lu7did/QCX-SSB/USDX_V2/README.md

USDX_V2
======

Spanish version of the QCX-SSB code ported by Pablo Cardeñosa (EA2EHC) for his board
the USDX_V2.
The board implements the firmware on a standard Arduino Nano board running
at 16 MHz.

The original of this file should be retrieved from the files section of the
groups.io/ucx forum.
