lu7did/QCX-SSB/Pixie-SSB/crypt/Pixie-SSB-PinoutMap.xlsx

ATMega328A | Pin | Arduino | QCX | Pixie
PD0 | 2 | D0 | LCD_D4 | --
PD1 | 3 | D1 | LCD_D5 | --
PD2 | 4 | D2 | LCD_D6 | ROT_A
PD3 | 5 | D3 | LCD_D7 | ROT_B
PD4 | 6 | D4 | LCD_EN | LCD_D4
PD5 | 11 | D5 | FREQ_CNT | LCD_D5
PD6 | 12 | D6 | ROT_A | LCD_D6
PD7 | 13 | D7 | ROT_B | LCD_D7
PB0 | 14 | D8 | RX | LCD_RS
PB1 | 15 | D9 | SIDETONE | LCD_ENABLE
PB2 | 16 | D10 | KEY_OUT | LCD_LIGHT
PB3 | 17 | D11 | SIG_OUT | KEY_OUT
PB4 | 18 | D12 | DAH | DAH
PB5 | 19 | D13 | DIT | DIT
PC0/A0 | 23 | A0 | AUDIO1 | BUTTONS
PC1/A1 | 24 | A1 | AUDIO2 | --
PC2/A2 | 25 | A2 | DVM | --
PC3/A3 | 26 | A3 | BUTTONS | --
PC4 | 27 | A4 | LCD_RS | --
PC4 | 27 | A4 | SDA | SDA
PC5 | 28 | A5 | SCL | SCL
PB3 | 17
