lu7did/QCX-SSB/USDX_V2/usdx_SD_V2_ea2ehc_f.jpg

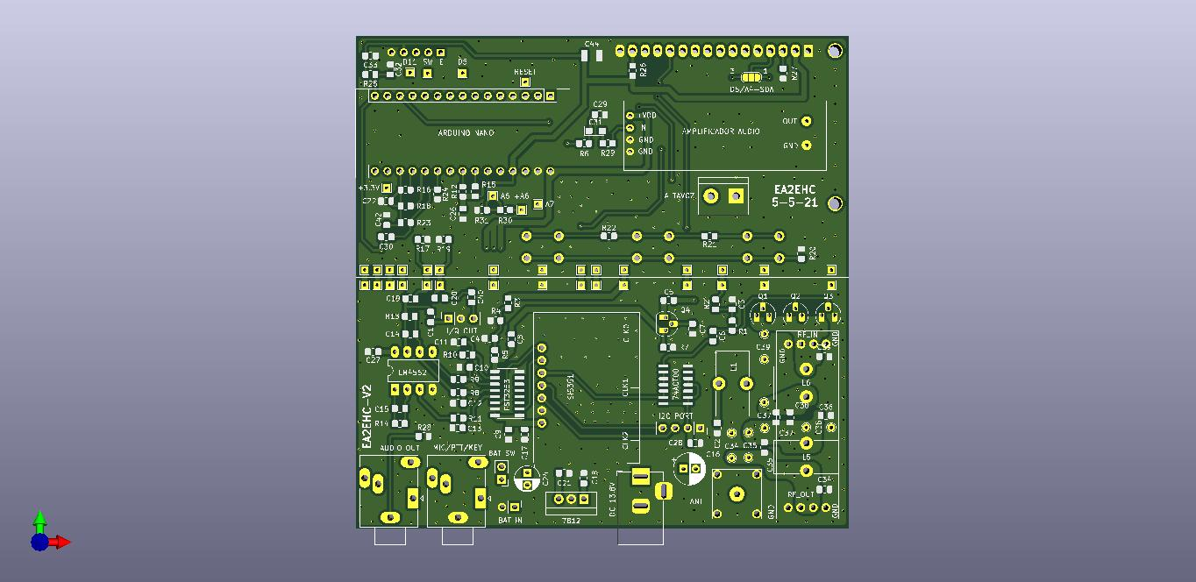
USDX_V2/usdx_SD_V2_ea2ehc_f.jpg
