lu7did/QCX-SSB/Pixie-SSB/testADC/testADC.ino/test1.txt

0,359,360
1,355,388
2,353,408
3,352,428
4,351,448
5,350,468
6,350,488
7,349,508
8,348,528
9,348,548
10,348,568
11,347,588
12,347,608
13,346,628
14,345,648
15,345,668
16,345,688
17,344,708
18,344,728
19,344,748
20,344,768
21,344,788
22,344,808
23,344,828
24,344,848
25,344,868
26,343,888
27,343,908
28,343,928
29,343,948
30,343,968
31,342,988
32,342,1008
33,342,1032
34,342,1048
35,342,1068
36,341,1088
37,341,1108
38,342,1128
39,341,1148
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
