lu7did/QCX-SSB/Pixie-SSB/testADC/testADC.ino/test2.txt

0,0,360
1,0,388
2,0,408
3,0,428
4,6,448
5,20,468
6,34,488
7,49,508
8,62,528
9,73,548
10,83,568
11,91,588
12,96,608
13,99,628
14,97,648
15,96,668
16,91,688
17,83,708
18,71,728
19,60,748
20,47,768
21,33,788
22,19,808
23,4,828
24,0,848
25,0,868
26,0,888
27,0,908
28,0,928
29,0,948
30,0,968
31,0,988
32,0,1008
33,0,1032
34,0,1048
35,0,1068
36,0,1088
37,0,1108
38,15,1128
39,30,1148
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
