lu7did/QCX-SSB/Pixie-SSB/testADC/testADC.ino/test3.txt

0,127,360
1,131,388
2,135,408
3,140,428
4,140,448
5,141,468
6,139,488
7,135,508
8,131,528
9,124,548
10,116,568
11,109,588
12,99,608
13,92,628
14,83,648
15,74,668
16,67,688
17,60,708
18,53,728
19,51,748
20,48,768
21,45,788
22,47,808
23,49,828
24,52,848
25,59,868
26,66,888
27,72,908
28,82,928
29,91,948
30,99,968
31,108,988
32,115,1008
33,123,1032
34,130,1048
35,135,1068
36,139,1088
37,140,1108
38,141,1128
39,139,1148
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
