lu7did/QCX-SSB/Pixie-SSB/testADC/testADC.ino/test4.txt

0,150,360
1,144,388
2,142,408
3,137,428
4,131,448
5,123,468
6,113,488
7,103,508
8,95,528
9,84,548
10,73,568
11,65,588
12,55,608
13,49,628
14,43,648
15,39,668
16,36,688
17,36,708
18,39,728
19,41,748
20,47,768
21,54,788
22,63,808
23,71,828
24,81,848
25,92,868
26,102,888
27,111,908
28,120,928
29,129,948
30,135,968
31,140,988
32,143,1008
33,145,1032
34,146,1048
35,142,1068
36,139,1088
37,132,1108
38,126,1128
39,118,1148
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
