lu7did/QCX-SSB/Pixie-SSB/testADC/testADC.ino/test5.txt

0,35,360
1,25,388
2,22,408
3,22,428
4,24,448
5,31,468
6,35,488
7,47,508
8,56,528
9,69,548
10,82,568
11,94,588
12,107,608
13,119,628
14,129,648
15,139,668
16,147,688
17,153,708
18,157,728
19,159,748
20,157,768
21,153,788
22,148,808
23,140,828
24,131,848
25,119,868
26,108,888
27,94,908
28,82,928
29,68,948
30,55,968
31,47,988
32,39,1008
33,31,1032
34,26,1048
35,23,1068
36,23,1088
37,25,1108
38,28,1128
39,35,1148
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
