lu7did/QCX-SSB/Pixie-SSB/testADC/testADC.ino/test6.txt

0,41,-28,360
1,27,-42,388
2,22,-47,408
3,20,-49,428
4,20,-49,448
5,22,-47,468
6,27,-42,488
7,34,-35,508
8,44,-25,528
9,54,-15,548
10,65,-4,568
11,76,7,588
12,91,22,608
13,103,34,628
14,115,46,648
15,126,57,668
16,135,66,688
17,143,74,708
18,151,82,728
19,154,85,748
20,156,87,768
21,155,86,788
22,152,83,808
23,146,77,828
24,139,70,848
25,129,60,868
26,118,49,888
27,107,38,908
28,94,25,928
29,82,13,948
30,69,0,968
31,56,-13,988
32,46,-23,1008
33,36,-33,1032
34,29,-40,1048
35,24,-45,1068
36,21,-48,1088
37,19,-50,1108
38,21,-48,1128
39,25,-44,1148
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
