lu7did/QCX-SSB/Pixie-SSB/testADC/testADC.ino/test7A.txt

0,91,4,360
1,87,0,388
2,86,-1,408
3,86,-1,428
4,87,0,448
5,86,-1,468
6,86,-1,488
7,87,0,508
8,87,0,528
9,86,-1,548
10,86,-1,568
11,86,-1,588
12,87,0,608
13,87,0,628
14,84,-3,648
15,86,-1,668
16,88,1,688
17,87,0,708
18,87,0,728
19,86,-1,748
20,86,-1,768
21,86,-1,788
22,87,0,808
23,87,0,828
24,86,-1,848
25,87,0,868
26,87,0,888
27,87,0,908
28,87,0,928
29,86,-1,948
30,86,-1,968
31,86,-1,988
32,86,-1,1008
33,87,0,1032
34,86,-1,1048
35,86,-1,1068
36,87,0,1088
37,86,-1,1108
38,86,-1,1128
39,87,0,1148
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
