lu7did/QCX-SSB/Pixie-SSB/testADC/testADC.ino/test7B.txt

0,38,-48,360
1,47,-39,388
2,58,-28,408
3,70,-16,428
4,83,-3,448
5,95,9,468
6,108,22,488
7,120,34,508
8,130,44,528
9,140,54,548
10,147,61,568
11,152,66,588
12,153,67,608
13,153,67,628
14,152,66,648
15,147,61,668
16,141,55,688
17,132,46,708
18,121,35,728
19,111,25,748
20,98,12,768
21,85,-1,788
22,73,-13,808
23,60,-26,828
24,49,-37,848
25,36,-50,868
26,30,-56,888
27,24,-62,908
28,20,-66,928
29,17,-69,948
30,19,-67,968
31,22,-64,988
32,27,-59,1008
33,34,-52,1032
34,44,-42,1048
35,55,-31,1068
36,67,-19,1088
37,79,-7,1108
38,92,6,1128
39,103,17,1148
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
