lu7did/QCX-SSB/Pixie-SSB/testADC/testADC.ino/test__SSB1.txt

0,0,-89,-2
1,-2,-91,32
2,-2,-91,28
3,-2,-91,28
4,-2,-91,32
5,-2,-91,28
6,-2,-91,28
7,-2,-91,28
8,-2,-91,32
9,-2,-91,56
10,-2,-91,60
11,-2,-91,56
12,-2,-91,60
13,-2,-91,60
14,-2,-91,60
15,-2,-91,60
16,-2,-91,60
17,-2,-91,56
18,-2,-91,60
19,-2,-91,56
20,-2,-91,60
21,-2,-91,56
22,-2,-91,60
23,-2,-91,56
24,-2,-91,60
25,-2,-91,60
26,-1,-90,56
27,-1,-90,60
28,-1,-90,56
29,-2,-91,60
30,-1,-90,56
31,-1,-90,60
32,-1,-90,56
33,-1,-90,60
34,-1,-90,28
35,-1,-90,28
36,-1,-90,32
37,-2,-91,56
38,-1,-90,28
39,-1,-90,32
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
