lu7did/QCX-SSB/Pixie-SSB/testADC/testADC.ino/test__SSB2.txt

0,0,-87,-20
1,-8,-95,32
2,-19,-106,32
3,-38,-125,28
4,-49,-136,28
5,-58,-145,28
6,-64,-151,56
7,-58,-145,60
8,-24,-111,56
9,13,-74,60
10,57,-30,60
11,69,-18,60
12,56,-31,60
13,0,-87,60
14,-36,-123,60
15,-68,-155,60
16,-59,-146,56
17,-21,-108,60
18,30,-57,56
19,65,-22,60
20,68,-19,60
21,40,-47,60
22,-8,-95,60
23,-43,-130,60
24,-68,-155,56
25,-55,-142,60
26,-11,-98,56
27,37,-50,60
28,62,-25,60
29,60,-27,60
30,33,-54,60
31,-16,-103,56
32,-57,-144,60
33,-67,-154,60
34,-49,-136,60
35,-4,-91,56
36,44,-43,60
37,66,-21,56
38,63,-24,60
39,25,-62,56
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
