lu7did/QCX-SSB/Pixie-SSB/testADC/testADC.ino/test__SSB3.txt

0,0,-88,1
1,1,-87,32
2,0,-88,32
3,-11,-99,32
4,-21,-109,28
5,-39,-127,28
6,-51,-139,32
7,-65,-153,28
8,-68,-156,112
9,-65,-153,112
10,3,-85,112
11,67,-21,112
12,42,-46,112
13,-42,-130,116
14,-61,-149,112
15,-1,-89,112
16,67,-21,116
17,35,-53,112
18,-39,-127,112
19,-63,-151,112
20,8,-80,112
21,68,-20,112
22,39,-49,116
23,-46,-134,116
24,-64,-152,112
25,3,-85,108
26,64,-24,112
27,42,-46,116
28,-42,-130,116
29,-63,-151,112
30,0,-88,112
31,65,-23,116
32,44,-44,116
33,-39,-127,112
34,-67,-155,108
35,-5,-93,112
36,65,-23,112
37,37,-51,116
38,-34,-122,112
39,-64,-152,112
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
