lu7did/QCX-SSB/Pixie-SSB/testADC/testADC.ino/test__SSB4.txt

0,0,-24,9319
1,-10,0,32
2,-23,0,32
3,-42,0,28
4,-50,0,28
5,-55,0,28
6,-50,12500,112
7,-28,0,112
8,46,0,112
9,68,5524,116
10,14,2943,112
11,-61,4033,112
12,-43,20039,112
13,28,3325,112
14,67,3643,112
15,18,3873,116
16,-59,7580,112
17,-56,8199,112
18,24,8453,112
19,68,9651,112
20,11,26028,116
21,-56,9951,112
22,-50,9383,112
23,20,10060,112
24,68,9743,112
25,27,25238,112
26,-54,10192,112
27,-53,10192,112
28,27,10593,112
29,68,9823,112
30,18,24985,112
31,-52,9798,112
32,-56,9226,112
33,11,10069,112
34,68,10378,112
35,23,25653,112
36,-56,10630,112
37,-58,9839,112
38,19,10092,112
39,67,9588,112
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
