lu7did/QCX-SSB/Pixie-SSB/testADC/testADC.ino/test__SSB5.txt

0,0,0,0,-1
1,-1,0,0,0
2,-2,0,0,0
3,-2,0,0,0
4,-2,0,0,0
5,0,0,0,0
6,-2,0,0,0
7,-2,0,0,0
8,0,0,0,0
9,-1,25000,-1,0
10,-1,0,-1,0
11,-2,0,-1,0
12,-1,21786,-1,-1
13,-1,18750,1,0
14,-1,18750,-1,1
15,-1,28036,-1,-1
16,-1,18750,1,0
17,-2,0,0,0
18,-2,0,0,0
19,-1,25000,-1,0
20,-1,-25000,0,0
21,-1,0,0,0
22,-1,0,0,0
23,-2,0,0,0
24,-1,0,0,0
25,0,25000,-1,0
26,-1,0,-1,0
27,-1,-25000,0,0
28,-1,0,0,0
29,-2,0,0,0
30,-2,0,0,0
31,-1,25000,-1,0
32,-1,28036,0,-1
33,-1,12500,1,0
34,-2,0,0,0
35,0,0,0,0
36,-2,0,0,0
37,-1,25000,-1,0
38,-1,0,-1,0
39,-2,-25000,0,0
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
