lu7did/QCX-SSB/Pixie-SSB/testADC/testADC.ino/test__SSB6.txt

0,0,51,9278,-43
1,2,0,0,0
2,3,0,0,0
3,-1,0,0,0
4,-10,0,0,0
5,-22,0,0,0
6,-40,0,0,0
7,-51,0,0,0
8,-61,0,0,0
9,-66,6250,1,1
10,-67,3662,1,3
11,-8,5176,-2,6
12,58,3662,-6,6
13,58,1578,-9,6
14,-21,3501,-14,2
15,-67,18552,-13,-3
16,-25,3268,-12,-9
17,47,2274,-9,-12
18,64,3613,-5,-27
19,9,7199,27,-31
20,-63,7159,47,2
21,21,8014,24,42
22,31,9492,-28,35
23,68,25571,-37,-14
24,26,10243,3,-39
25,-55,9582,38,-11
26,-62,7911,28,24
27,2,9510,-14,41
28,62,28560,-43,-18
29,40,14310,21,-29
30,-68,8044,16,1
31,-66,2816,27,12
32,-15,10635,-8,44
33,55,9583,-45,8
34,54,24291,-26,-34
35,-15,9241,19,-34
36,-41,9073,40,3
37,-30,10326,9,47
38,42,11554,-50,16
39,63,25958,-24,-37
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
