lu7did/QCX-SSB/Pixie-SSB/testADC/testADC.ino/testADC.xls.xlsx

Sheet: test1
0 | 378
1 | 374
2 | 372
3 | 371
4 | 371
5 | 370
6 | 370
7 | 370
8 | 369
9 | 369
10 | 369
11 | 369
12 | 368
13 | 368
14 | 368
15 | 368
16 | 368
17 | 368
18 | 368
19 | 368
20 | 368
21 | 368
22 | 368
23 | 368
24 | 368
25 | 368
26 | 368
27 | 369
28 | 368
29 | 369
30 | 368
31 | 369
32 | 369
33 | 369
34 | 369
35 | 369
36 | 369
37 | 369
38 | 369
39 | 370
40 | 369
41 | 370
42 | 370
43 | 370
44 | 370
45 | 370
46 | 371
47 | 371
48 | 371
49 | 371
50 | 371
51 | 371
52 | 371
53 | 371
54 | 371
55 | 372
56 | 372
57 | 372
58 | 372
59 | 373
60 | 374
61 | 374
62 | 374
63 | 374
64 | 374
65 | 374
66 | 375
67 | 375
68 | 376
69 | 376
70 | 376
71 | 376
72 | 376
73 | 376
74 | 376
75 | 377
76 | 377
77 | 377
78 | 377
79 | 378
80 | 378
81 | 379
82 | 379
83 | 379
84 | 379
85 | 379
86 | 379
87 | 380
88 | 380
89 | 380
90 | 380
91 | 380
92 | 381
93 | 381
94 | 382
95 | 382
96 | 382
97 | 382
98 | 382
99 | 382
100 | 383
101 | 384
102 | 384
103 | 384
104 | 384
105 | 384
106 | 384
107 | 384
108 | 384
109 | 384
110 | 384
111 | 384
112 | 384
113 | 384
114 | 384
115 | 384
116 | 385
117 | 385
118 | 385
119 | 385
120 | 385
121 | 385
122 | 385
123 | 386
124 | 386
125 | 386
126 | 386
127 | 386
128 | 387
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
