lu7did/QCX-SSB/Pixie-SSB/crypt/si5351/si5351.ino

#include <Wire.h>
#include <Adafruit_SI5351.h>
#include <LiquidCrystal.h>

LiquidCrystal lcd(8, 9, 4, 5, 6, 7);
Adafruit_SI5351 clockgen = Adafruit_SI5351();

/**************************************************************************/
/*
    Arduino setup function (automatically called at startup)
*/
/**************************************************************************/
void setup(void) 
{
  Serial.begin(9600);
  Serial.println("Pixie Test -- Si5351 Clockgen Test"); Serial.println("");
  
  /* Initialise the sensor */
  if (clockgen.begin() != ERROR_NONE)
  {
    /* There was a problem detecting the IC ... check your connections */
    Serial.print("Ooops, no Si5351 detected ... Check your wiring or I2C ADDR!");
    while(1);
  }
  
  /* Uncomment the next line to speed up the I2C communication */
  Wire.setClock(400000);
  
  /* INTEGER ONLY MODE --> most accurate output */  
  /* Setup PLLA to integer only mode @ 900MHz (must be 600..900MHz) */
  /* Set Multisynth 0 to 112.5MHz using integer only mode (div by 4/6/8) */
  /* 25MHz * 36 = 900 MHz, then 900 MHz / 8 = 112.5 MHz */
  Serial.println("Set PLLA to 900MHz");
  clockgen.setupPLLInt(SI5351_PLL_A, 36);
  
  Serial.println("Set Output #2 to 112.5MHz");  
  clockgen.setupMultisynthInt(0, SI5351_PLL_A, SI5351_MULTISYNTH_DIV_8);

  /* FRACTIONAL MODE --> More flexible but introduce clock jitter */
  /* Setup PLLB to fractional mode @616.66667MHz (XTAL * 24 + 2/3) */
  /* Setup Multisynth 1 to 13.55311MHz (PLLB/45.5) */
  clockgen.setupPLL(SI5351_PLL_B, 24, 2, 3);
  Serial.println("Set Output #1 to 13.553115MHz");  
  
  clockgen.setupMultisynth(1, SI5351_PLL_B, 45, 1, 2);

  /* Multisynth 2 is not yet used and won't be enabled, but can be */
  /* Use PLLB @ 616.66667MHz, then divide by 900 -> 685.185 KHz */
  /* then divide by 64 for 10.706 KHz */
  /* configured using either PLL in either integer or fractional mode */

  Serial.println("Set Output #2 to 10.706 KHz");  
  clockgen.setupMultisynth(2, SI5351_PLL_B, 900, 0, 1);
  clockgen.setupRdiv(2, SI5351_R_DIV_64);
  
  pinMode(10,OUTPUT);
  digitalWrite(10,HIGH);
  
  lcd.begin(16, 2);  // Init LCD
  lcd.display();
  lcd.clear();
  lcd.setCursor(0,0);
  lcd.print("Clk02=10,706MHz");
  
  /* Enable the clocks */
  clockgen.enableOutputs(true);
}

/**************************************************************************/
/*
    Arduino loop function, called once 'setup' is complete (your own code
    should go here)
*/
/**************************************************************************/
void loop(void) 
{  
}
