lu7did/QCX-SSB/Pixie-SSB/crypt/CAT817.h

//*--------------------------------------------------------------------------------------------------
//* CAT817 CAT Management Class   (HEADER CLASS)
//*--------------------------------------------------------------------------------------------------
//* Este es el firmware del diseÃ±o de VFO para DDS
//* Solo para uso de radioaficionados, prohibido su utilizacion comercial
//* Copyright 2018 Dr. Pedro E. Colla (LU7DID)
//*--------------------------------------------------------------------------------------------------
#ifndef CAT817_h
#define CAT817_h
#define _NOP        (byte)0




#include <stdio.h>
#include <stdlib.h>
#include <stdint.h>
#include <string.h>
#include <errno.h>
#include <unistd.h>
#include <fcntl.h>
#include <time.h>
#include <signal.h>
#include <unistd.h>



//*---- Arduino invalid referencies

//#include <cmath>
//#include <wiringPi.h>
//#include <poll.h>
//#include <sched.h>
//#include <sys/mman.h>
//#include <pthread.h>
//#include <semaphore.h>
//#include <pigpio.h>
//#include <wiringPiI2C.h>
//#include <cstring>
//#include <iostream>
//#include <chrono>
//#include <thread>
//#include <functional>
//#include <wiringSerial.h>
//#include <sstream>
//#include <iomanip>
//#include <iostream>
//#include <cstdlib> // for std::rand() and std::srand()
//#include <ctime> // for std::time()
//#include <cmath>

//*--- end of invalid Arduino references

//*--- Function prototypes
void setWord(unsigned char* SysWord,unsigned char  v, bool val);
bool getWord (unsigned char SysWord, unsigned char v);

typedef unsigned char byte;
typedef bool boolean;
typedef void (*CALLBACK)();


#define MLSB   0x00
#define MUSB   0x01
#define MCW    0x02
#define MCWR   0x03
#define MAM    0x04
#define MWFM   0x06
#define MFM    0x08
#define MDIG   0x0A
#define MPKT   0x0C
#define SMETERMAX 14

//*--- Transmission control

#define AGC    0B01000000
//#define TXONLY 0B00100000
#define SHIFT  0B00100000
#define RITX   0B00010000
#define LOCK   0B00001000
#define PTT    0B00000100
#define SPLIT  0B00000010
#define VFO    0B00000001


//*---------------------------------------------------------------------------------------------------

//* VFOSystem CLASS
//*---------------------------------------------------------------------------------------------------
class CAT817
{
  public: 
  
      CAT817(CALLBACK f,CALLBACK s,CALLBACK m, CALLBACK r, CALLBACK t);
      
      CALLBACK changeFreq=NULL;
      CALLBACK changeMode=NULL;
      CALLBACK changeStatus=NULL;
      CALLBACK getRX=NULL;
      CALLBACK getTX=NULL;

      CALLBACK sendChar=NULL;

      void get();
      void hex2str(char* r, byte* b,int l);
      int  bcdToDec(int v);
      int  decToBcd(int v);
      int  BCD2Dec(byte* BCDBuf);
      void dec2BCD(byte* BCDBuf, int f);
      void sendSerial(byte* BCDBuf,int len);
      void processCAT(byte* rxBuffer);
      void open(char* port, int speed);
      void sendStatus();
      void sendMode();
      void close();
      void printDEBUG(byte t,char* m);
       int snr2code(int snr);

      int  RITOFS=0x00;
      byte MODEWORD=0xff;
      byte FT817;
      byte POWER=7;
      byte MODE=MUSB;
      byte TRACE=0x00;
      int  RX=0x00;
      byte TX=0x00;
      byte METER=0xFF;
      bool active=false;

      byte bufChar[128];
      int  bufLen=0;
      float f;
    
      int  n=0;
      byte rxBuffer[128];
      char buffer[128];

      byte fchangeMode=0x00;
      byte fchangeFreq=0x00;
      byte fchangeStatus=0x00;

//-------------------- GLOBAL VARIABLES ----------------------------
      //char   *PROGRAMID="CAT817";
      //char   *PROG_VERSION="1.0";
      //char   *PROG_BUILD="00";
      //char   *COPYRIGHT="(c) LU7DID 2019,2020";

 
  private:

      int serial_port;
      char msg[80]; 
};

#endif
//*---------------------------------------------------------------------------------------------------
//* CAT817 CLASS Implementation
//*--------------------------------------------------------------------------------------------------
//* Este es el firmware del diseÃ±o de CAT para DDS
//* Solo para uso de radioaficionados, prohibido su utilizacion comercial
//* Copyright 2018 Dr. Pedro E. Colla (LU7DID)
//*--------------------------------------------------------------------------------------------------
CAT817::CAT817(CALLBACK f,CALLBACK s,CALLBACK m, CALLBACK r, CALLBACK t)
{
  
  if (f!=NULL) {changeFreq=f;}   //* Callback of change VFO frequency
  if (s!=NULL) {changeStatus=s;} //* Callback of TX mode change
  if (m!=NULL) {changeMode=m;}   //* Callback of VFO Reset 
  if (r!=NULL) {getRX=r;}        //* Callback for RX Status
  if (t!=NULL) {getTX=t;}        //* Callback for TX Status
 
  this->FT817=0;
  this->MODE=MUSB;
  this->active=false;
  //std::srand(static_cast<unsigned int>(std::time(nullptr))); // set initial seed value to system clock
}
//#*---------------------------------------------------------------------------
//#* printDEBUG
//#* Print DEBUG
//#*---------------------------------------------------------------------------
void CAT817::printDEBUG(byte t,char* m) {

  if (t>this->TRACE) {
     return;
  }

  printf(m);

}
//#*---------------------------------------------------------------------------
//#* bcdToDec
//#* Convert nibble
//#*---------------------------------------------------------------------------
int CAT817::bcdToDec(int v) {
  return  (v/16*10) + (v%16);
} 
//#*--------------------------------------------------------------------------
//#* decToBcd
//#* Convert nibble
//#*-------------------------------------------------------------------------
int CAT817::decToBcd(int v){
  return  (v/10*16) + (v%10);
}
//#*---------------------------------------------------------------------------
//#* hex2str
//#* Convert byte to Hex string
//#*---------------------------------------------------------------------------
void CAT817::hex2str(char* r, byte* b,int l) {

      for(int j = 0; j < l; j++) {
         sprintf(&r[2*j], "%02X",b[j]);
      }
}
//#*---------------------------------------------------------------------------
//#* BCD2Dec
//#* Convert 4 BCD bytes to integer
//#*---------------------------------------------------------------------------
int CAT817::BCD2Dec(byte* BCDBuf) {

    int f=0;
    f=f+bcdToDec(BCDBuf[0])*1000000;
    f=f+bcdToDec(BCDBuf[1])*10000;
    f=f+bcdToDec(BCDBuf[2])*100;
    f=f+bcdToDec(BCDBuf[3])*1;
    f=f*10;
    return f;
}
//#*---------------------------------------------------------------------------
//#* dec2BCD
//#* Convert convert frequency integer into BCD
//#*---------------------------------------------------------------------------
void CAT817::dec2BCD(byte* BCDBuf, int f){

    int fz=int(f/10);
    int f0=int(fz/1000000);
  
    int x1=fz-f0*1000000;
    int f1=int(x1/10000);
  
    int x2=x1-f1*10000;
    int f2=int(x2/100);

    int x3=x2-f2*100;
    int f3=int(x3);

    f0=decToBcd(f0);
    f1=decToBcd(f1);
    f2=decToBcd(f2);
    f3=decToBcd(f3);

    BCDBuf[0]=f0;
    BCDBuf[1]=f1;
    BCDBuf[2]=f2;
    BCDBuf[3]=f3;


 }
//#*---------------------------------------------------------------------------
//#* sendSerial
//#* send buffer over serial link
//#*---------------------------------------------------------------------------
void CAT817::sendSerial(byte* BCDBuf,int len) {
    bufLen=0;
    for(int j = 0; j < len; j++) {
       if (sendChar != NULL) {
          bufChar[bufLen]=BCDBuf[j];
          bufChar[bufLen+1]=0x00;
          bufLen++;
       } else {
          //serialPutchar(serial_port,(char)BCDBuf[j]);
          Serial.write((char)BCDBuf[j]);

       }
    }
}
//#*---------------------------------------------------------------------------
//#* sendStatus callback
//#* After any command changing status the callback is made
//#*---------------------------------------------------------------------------
void CAT817::sendStatus() {
    if (changeStatus != NULL) {
       fchangeStatus=0x01;
       changeStatus();
    }
} 
//#*---------------------------------------------------------------------------
//#* sendMode callback
//#* After any command changing the transceiver mode the callback is made
//#*---------------------------------------------------------------------------
void CAT817::sendMode() {
    if (changeMode != NULL) {
       fchangeMode=0x01;
       changeMode();
    }
} 
//#*---------------------------------------------------------------------------
//#* processCAT
//#* After a full command has been received process it
//#*---------------------------------------------------------------------------
void CAT817::processCAT(byte* rxBuffer) {

    byte BCDBuf[6];
    char buffer[18];

    BCDBuf[0]=0x00;
    BCDBuf[1]=0x00;
    BCDBuf[2]=0x00;
    BCDBuf[3]=0x00;
    BCDBuf[4]=0x00;
    BCDBuf[5]=0x00;

    switch(rxBuffer[4]) {
      case 0x01:  {       //* Set Frequency
       int freq=BCD2Dec(&rxBuffer[0]);
       this->f=freq;
       BCDBuf[4]=0x01;
       hex2str(&buffer[0],&BCDBuf[0],1);
       //(TRACE>=0x02 ? fprintf(stderr,"%s::processCAT() Command 0x01 Resp(%s)\n",this->PROGRAMID,(char*) &buffer[0]) : _NOP);
       if (changeFreq != NULL) {
          fchangeFreq=0x01;
          changeFreq();
       }
       BCDBuf[0]=0x00;
       sendSerial(&BCDBuf[0],1);
       sendStatus();
       return;}
      case 0x03:  {        //* Get Frequency and Mode
       int freq=(int)f;
       dec2BCD(&BCDBuf[0],freq);
       BCDBuf[4]=MODE;
       hex2str(&buffer[0],&BCDBuf[0],5);
       //(TRACE>=0x03 ? fprintf(stderr,"%s::processCAT() Command 0x03 Resp(%s)\n",this->PROGRAMID,buffer) : _NOP);
       sendSerial(&BCDBuf[0],5);
       return;}
      case 0x00: {   //* LOCK status flip
       if(getWord(FT817,LOCK)==true) {
         BCDBuf[0]=0xF0;
       } else {
         BCDBuf[0]=0x00;
       }
       setWord(&FT817,LOCK,true);
       hex2str(&buffer[0],&BCDBuf[0],1);
       //(TRACE>=0x02 ? fprintf(stderr,"%s::processCAT() Command 0x00 Resp(%s)\n",this->PROGRAMID,buffer) : _NOP);
       sendSerial(&BCDBuf[0],1);
       sendStatus();
       return; }
      case 0x02: { //* SPLIT status flip
       if(getWord(FT817,SPLIT)==true) {
         setWord(&FT817,SPLIT,false);
         BCDBuf[0]=0xF0;
       } else {
         setWord(&FT817,SPLIT,true);
         BCDBuf[0]=0x00;
       }
       hex2str(&buffer[0],&BCDBuf[0],1);
       //(TRACE>=0x02 ? fprintf(stderr,"%s::processCAT() Command 0x02 Resp(%s)\n",this->PROGRAMID,buffer) : _NOP);
       sendSerial(&BCDBuf[0],1);
       sendStatus();
       return;}
      case 0x05: { //* RIT status flip
       if(getWord(FT817,RITX)==true) {
         setWord(&FT817,RITX,false);
         BCDBuf[0]=0xF0;
       } else {
         setWord(&FT817,RITX,true);
         BCDBuf[0]=0x00;
       }
       hex2str(&buffer[0],&BCDBuf[0],1);
       //(TRACE>=0x02 ? fprintf(stderr,"%s::processCAT() Command 0x05 Resp(%s)\n",this->PROGRAMID,buffer) : _NOP);
       sendSerial(&BCDBuf[0],1);
       sendStatus();
       return;}
      case 0x07: {      //* Transceiver mode change
       byte mode=rxBuffer[0] & MODEWORD;       //* Prevent invalid values to be set
       if (mode != MLSB && mode != MUSB && mode != MCW && mode != MCWR && mode != MAM && mode != MWFM && mode != MFM && mode != MDIG && mode != MPKT) {
          hex2str(&buffer[0],&rxBuffer[0],1);
          //(TRACE>=0x01 ? fprintf(stderr,"%s::processCAT() Command 0x07 Invalid mode(%s)\n",this->PROGRAMID,buffer) : _NOP);
          return;
       }
       MODE=mode;
       BCDBuf[0]=0x00;
       hex2str(&buffer[0],&BCDBuf[0],1);
       //(TRACE>=0x02 ? fprintf(stderr,"%s::processCAT() Command 0x07 Resp(%s)\n",this->PROGRAMID,buffer) : _NOP);
       sendSerial(&BCDBuf[0],1);
       sendMode();
       return;}
      case 0x08: {     //* Undocummented feature returns 0x00 if transceiver unkeyed 0xF0 if keyed
       if(getWord(FT817,PTT)==true) {
         BCDBuf[0]=0xF0;
       } else {
         BCDBuf[0]=0x00;
       }
       setWord(&FT817,PTT,true);
       hex2str(&buffer[0],&BCDBuf[0],1);
       //(TRACE>=0x02 ? fprintf(stderr,"%s::processCAT() Command 0x08 Resp(%s) PTT(On)\n",this->PROGRAMID,buffer) : _NOP);
       sendSerial(&BCDBuf[0],1);
       sendStatus();
       return;}
      case 0x80: {      //* Turn the LOCK off
       if(getWord(FT817,LOCK)==false) {
         BCDBuf[0]=0xF0;
       } else {
         BCDBuf[0]=0x00;
       }
       setWord(&FT817,LOCK,false);
       hex2str(&buffer[0],&BCDBuf[0],1);
       //(TRACE>=0x02 ? fprintf(stderr,"%s::processCAT() Command 0x80 Resp(%s)\n",this->PROGRAMID,buffer) : _NOP);
       sendSerial(&BCDBuf[0],1);
       sendStatus();
       return; }
      case 0x81:  {
       BCDBuf[0]=0x00;
       (getWord(FT817,VFO)==false?setWord(&FT817,VFO,true):setWord(&FT817,VFO,false));
       BCDBuf[0]=0x00;
       hex2str(&buffer[0],&BCDBuf[0],1);
       //(TRACE>=0x02 ? fprintf(stderr,"%s::processCAT() Command 0x81 Resp(%s)\n",this->PROGRAMID,buffer) : _NOP);
       sendSerial(&BCDBuf[0],1);
       sendStatus();
       return;}
      case 0x82: {      //* Turn the SPLIT off
       if(getWord(FT817,SPLIT)==false) {
         BCDBuf[0]=0xF0;
       } else {
         BCDBuf[0]=0x00;
       }
       setWord(&FT817,SPLIT,false);
       hex2str(&buffer[0],&BCDBuf[0],1);
       //(TRACE>=0x02 ? fprintf(stderr,"%s::processCAT() Command 0x82 Resp(%s)\n",this->PROGRAMID,buffer) : _NOP);
       sendSerial(&BCDBuf[0],1);
       sendStatus();
       return; }
      case 0x85: {      //* Turn the RIT off
       if(getWord(FT817,RITX)==false) {
         BCDBuf[0]=0xF0;
       } else {
         BCDBuf[0]=0x00;
       }
       setWord(&FT817,RITX,false);
       hex2str(&buffer[0],&BCDBuf[0],1);
       //(TRACE>=0x02 ? fprintf(stderr,"%s::processCAT() Command 0x85 Resp(%s)\n",this->PROGRAMID,buffer) : _NOP);
       sendSerial(&BCDBuf[0],1);
       sendStatus();
       return; }
      case 0x88: {      //* Turn the TX On
       if(getWord(FT817,PTT)==false) {
         BCDBuf[0]=0xF0;
       } else {
         BCDBuf[0]=0x00;
       }
       setWord(&FT817,PTT,false);
       hex2str(&buffer[0],&BCDBuf[0],1);
       //(TRACE>=0x02 ? fprintf(stderr,"%s::processCAT() Command 0x88 Resp(%s) PTT(Off)\n",this->PROGRAMID,buffer) : _NOP);
       sendSerial(&BCDBuf[0],1);
       sendStatus();
       return; }
      case 0xBB:  {     //* only address 0x55 is supported the rest is answered nominally without modifications
       if (rxBuffer[1]==0x55) {
          BCDBuf[0]=0x80;
          BCDBuf[1]=0x00;
          if (getWord(FT817,VFO)==true) {
             BCDBuf[0]=BCDBuf[0] | 0x01;
          }
          hex2str(&buffer[0],&BCDBuf[0],2);
          //(TRACE>=0x03 ? fprintf(stderr,"%s::processCAT() Command 0xBB Resp(%s)\n",this->PROGRAMID,buffer) : _NOP);
          sendSerial(&BCDBuf[0],2);
          return;
       } 
       if (rxBuffer[1]==0x64) {
          BCDBuf[0]=0x00;
          BCDBuf[1]=0x00;
          hex2str(&buffer[0],&BCDBuf[0],2);
          //(TRACE>=0x03 ? fprintf(stderr,"%s::processCAT() Command 0x64 Resp(%s)\n",this->PROGRAMID,buffer) : _NOP);
          sendSerial(&BCDBuf[0],2);
          return;
       } 
       hex2str(&buffer[0],&rxBuffer[1],1);
       //(TRACE>=0x01 ? fprintf(stderr,"%s::processCAT() Command 0x64 Resp(%s)\n",this->PROGRAMID,buffer) : _NOP);
       return;
       }
      
      case 0xF5: {      //* Set Clarifier Frequency (not implemented yet)
       byte offsetBuf[5];
       offsetBuf[2]=rxBuffer[2];
       offsetBuf[3]=rxBuffer[3];
       offsetBuf[0]=0x00;
       offsetBuf[1]=0x00;
       offsetBuf[4]=0xF5;
       int ofs=BCD2Dec(&offsetBuf[0]);
       ofs=ofs/10;
       if (rxBuffer[0]==0x00) {
          RITOFS=+ofs;
       } else {
          RITOFS=(-1)*ofs;
       }
       //(TRACE>=0x02 ? fprintf(stderr,"%s::processCAT() Command 0xF5 Resp(%s)\n",this->PROGRAMID,buffer) : _NOP);
       BCDBuf[0]=0x00;
       sendSerial(&BCDBuf[0],1);
       sendStatus();
       return; }  
      case 0xE7:  {     //* Receiver Status
       //int RX;
       if (METER>0x0F) {
          //float prng= (float)std::rand();
          float prng= 0.0;
          float pmax= (float)RAND_MAX;
          RX  = (SMETERMAX*(float(prng/pmax)));
          if (RX<0x06) { RX=0x06; }  // this is actually a simulation to keep the indicator alive, no signals below S6 are realistic on HF....
       } else {
          RX  = METER;
       }

       if (getRX!=NULL) {
          getRX();
       }

//*----- S-Meter signal coded for command 0xE7
//*----- xxxx0000 S0
//*----- xxxx0001 S1
//*----- xxxx0010 S2
//*----- xxxx0011 S3
//*----- xxxx0100 S4
//*----- xxxx0101 S5
//*----- xxxx0110 S6
//*----- xxxx0111 S7
//*----- xxxx1000 S8
//*----- xxxx1001 S9
//*----- xxxx1010 S9+10dB
//*----- xxxx1011 S9+20dB
//*----- xxxx1100 S9+30dB
//*----- xxxx1101 S9+40dB
//*----- xxxx1110 S9+50dB
//*----- xxxx1111 S9+60dB

       BCDBuf[0]=((int)RX & 0x0f) | 0x00;     //* Either fake level or extracted from receiver
       hex2str(&buffer[0],&BCDBuf[0],1);
       //(TRACE>=0x03 ? fprintf(stderr,"%s::processCAT() Command 0xE7 Resp(%s)\n",this->PROGRAMID,buffer) : _NOP);
       sendSerial(&BCDBuf[0],1);
       return;}

      case 0xF7:  {     //* Transmitter status
       BCDBuf[0]=0x00;
       if (getWord(FT817,PTT)==true) {

          (getWord(FT817,PTT)==false  ? BCDBuf[0]=BCDBuf[0] | 0B10000000 : BCDBuf[0]=BCDBuf[0] & 0B01111111);
          (getWord(FT817,SPLIT)==true ? BCDBuf[0]=BCDBuf[0] | 0B00100000 : BCDBuf[0]=BCDBuf[0] & 0B11011111);
          BCDBuf[0]=BCDBuf[0] & 0B10111111;

          TX=(int)POWER*2;
          BCDBuf[0]=BCDBuf[0] | ((((int)TX) & 0x0f));

       } else {
          BCDBuf[0]=0B10000000;
       }
       hex2str(&buffer[0],&BCDBuf[0],1);
       //(TRACE>=0x03 ? fprintf(stderr,"%s::processCAT() Command 0xF7 Resp(%s)\n",this->PROGRAMID,buffer) : _NOP);  //modificar a 0x02
       sendSerial(&BCDBuf[0],1);
       return;}

      case 0xBD:  {   //* TX Metering

       if (getWord(FT817,PTT)==false) {
          BCDBuf[0]=0x00;
          sendSerial(&BCDBuf[0],1);
          return;
       }
       

       BCDBuf[0]=BCDBuf[0] | ((((POWER*2) & 0x0f) << 1) & 0xf0) | 0x01;
       BCDBuf[1]=0x11;
       hex2str(&buffer[0],&BCDBuf[0],2);
       //(TRACE>=0x03 ? fprintf(stderr,"%s::processCAT() Command 0xBD Resp(%s)",this->PROGRAMID,buffer) : _NOP);
       sendSerial(&BCDBuf[0],2);
       return; }

      default:    {
       //hex2str(&buffer[0],&rxBuffer[4],1);
       //sprintf(msg,"Invalid or unknown code %s\n",&buffer[0]);
       //(TRACE>=0X01 ? fprintf(stderr,msg) : _NOP);
       return;}
     } 


}
//*---------------------------------------------------------------------------------------------------------
// sig2code (FT817 coding)
//*----- S-Meter signal coded for command 0xE7
//*----- xxxx0000 S0
//*----- xxxx0001 S1
//*----- xxxx0010 S2
//*----- xxxx0011 S3
//*----- xxxx0100 S4
//*----- xxxx0101 S5
//*----- xxxx0110 S6
//*----- xxxx0111 S7
//*----- xxxx1000 S8
//*----- xxxx1001 S9
//*----- xxxx1010 S9+10dB
//*----- xxxx1011 S9+20dB
//*----- xxxx1100 S9+30dB
//*----- xxxx1101 S9+40dB
//*----- xxxx1110 S9+50dB
//*----- xxxx1111 S9+60dB
//*----------------------------------------------------------------------------------------------
int CAT817::snr2code(int snr) {

    if (snr <= -121) { return 0B0000000; }              //S0
    if (snr > -121 && snr <= -115) {return 0B00000001;} //S1
    if (snr > -115 && snr <= -109) {return 0B00000010;} //S2
    if (snr > -109 && snr <= -106) {return 0B00000011;} //S3
    if (snr > -106 && snr <= -97)  {return 0b00000100;} //S4
    if (snr > -97 && snr <= -91)   {return 0b00000101;} //S5
    if (snr > -91 && snr <= -85)   {return 0b00000110;} //S6
    if (snr > -85 && snr <= -79)   {return 0b00000111;} //S7
    if (snr > -79 && snr <= -73)   {return 0b00001000;} //S8
    if (snr > -73 && snr <= -67)   {return 0b00001001;} //S9
    if (snr > -67 && snr <= -57)   {return 0b00001010;} //S9+10dB
    if (snr > -57 && snr <= -47)   {return 0b00001011;} //S9+20dB
    if (snr > -47 && snr <= -37)   {return 0b00001100;} //S9+30dB
    if (snr > -37 && snr <= -27)   {return 0b00001101;} //S9+40dB
    if (snr > -27 && snr <= -17)   {return 0b00001110;} //S9+50dB
    if (snr > -17)                 {return 0b00001111;} //S9+60dB

    return 0x0f;

}
//*-------------------------------------------------------------------------
//* close
//* close the serial link and disable the CAT operation if successful
//*-------------------------------------------------------------------------

void CAT817::close() {

    if (this->active==true) {
       //serialClose(this->serial_port);
       this->active=false;
    }

    return;
}
//*-------------------------------------------------------------------------
//* open
//* open the serial link and enable the CAT operation if successful
//*-------------------------------------------------------------------------
void CAT817::open(char* port, int speed) {

    //if ((serial_port = serialOpen (port, speed)) < 0) {
    //   //(TRACE>=0x00 ? fprintf (stderr, "%s::open() Unable to open serial device: %s rc(%s)\n",this->PROGRAMID, port, strerror (errno)) : _NOP) ;
    //   this->active=false;
    //   return ;
    //}
    //(TRACE >= 0x02 ? fprintf(stderr, "%s::open() Opened port(%s) at baud(%d) serial(%d) tracelevel(%d)\n",this->PROGRAMID,port,speed,this->serial_port,TRACE) : _NOP);
    this->active=true;
}
//*-------------------------------------------------------------------------
//* get
//* get a character from the  serial port and process it
//*-------------------------------------------------------------------------
void CAT817::get() {

    //if (this->active==false) {
    //   (this->TRACE>=0x03 ? fprintf(stderr, "%s::get() Unable to process request, serial port problem(%d)\n",this->PROGRAMID,this->serial_port) : _NOP);
    //   return;
    //}
    char  buf[16];
    //if (this->serial_port < 0) {
    //   (this->TRACE>=0x00 ? fprintf(stderr, "%s::get() Unable to process request, serial port problem(%d)\n",this->PROGRAMID,this->serial_port) : _NOP);
    //   return;
    //}
    int maxFrame=4;
    
    //while(serialDataAvail(this->serial_port)) {
    while(Serial.available() > 0) {

       //char c = serialGetchar(this->serial_port);

       char c = Serial.read();
       byte k=(byte)c;
       rxBuffer[n]=k;
       n++;
       if (n==5) {
          char buffer[18];
          hex2str(&buffer[0],&rxBuffer[0],n);
          (TRACE>=0x03 ? fprintf (stderr,"%s::get() Received Serial hex2str (%s)\n",PROGRAMID,(char*) &buffer[0]) : _NOP);
          processCAT(&rxBuffer[0]);
          fflush (stdout) ;
          n=0;
          maxFrame--;
          if (maxFrame==0) { 
             return;  //If processed one command don't get stuck here
          }
       }
    }

}
