lu7did/QCX-SSB/Pixie-SSB/crypt/UtilLib.h

//*=*=*=*=*=*=*=*=*=*=*=*=*=*=*=*=*=*=*=*=*=*=*=*=*=*=*=*=*=*=*=*=*=*=*=*=*=*=*=*=*=*=*
//*              MAIN OBJECT DEFINITION
//*=*=*=*=*=*=*=*=*=*=*=*=*=*=*=*=*=*=*=*=*=*=*=*=*=*=*=*=*=*=*=*=*=*=*=*=*=*=*=*=*=*=*
//--------------------------[System Word Handler]---------------------------------------------------
// getSSW Return status according with the setting of the argument bit onto the SW
//--------------------------------------------------------------------------------------------------
bool getWord (unsigned char SysWord, unsigned char v) {

  return SysWord & v;

}
//--------------------------------------------------------------------------------------------------
// setSSW Sets a given bit of the system status Word (SSW)
//--------------------------------------------------------------------------------------------------
void setWord(unsigned char* SysWord,unsigned char v, bool val) {

  *SysWord = ~v & *SysWord;
  if (val == true) {
    *SysWord = *SysWord | v;
  }

}
//*--------------------------------------------------------------------------------------------
//* pciSETUP
//* setup interruptions, activate PCINT on a given Pin
//*--------------------------------------------------------------------------------------------
void pciSetup(byte pin)
{
    *digitalPinToPCMSK(pin) |= bit (digitalPinToPCMSKbit(pin));  // activar pin en PCMSK
    
    PCIFR  |= bit (digitalPinToPCICRbit(pin)); // limpiar flag de la interrupcion en PCIFR
    PCICR  |= bit (digitalPinToPCICRbit(pin)); // activar interrupcion para el grupo en PCICR
}
